elektron314/DMX8x8A-v1/Project Outputs for DMX8x8A-v1/Fabrication/Report Board Stack.xls

Board Stack Report
Stack Up |  | Layer Stack
Layer | Board Layer Stack | Name | Material | Thickness | Constant
1 |  | Top Paste
2 |  | Top Overlay
3 |  | Top Solder | SM-001 | 0.025mm | 4
4 |  | Top Layer | Copper | 0.035mm
5 |  | Dielectric 1 | Core-043 | 1.499mm | 4.3
6 |  | Bottom Layer | Copper | 0.035mm
7 |  | Bottom Solder | SM-001 | 0.025mm | 4
8 |  | Bottom Overlay
9 |  | Bottom Paste
 | Height : 1.619mm
