elektron314/DMX8x8A-v1/Project Outputs for DMX8x8A-v1/Assembly/DMX512 Decoder.xlsx

Designator | qnt | Value | Comment | Description | Footprint
C1, C2 | 2 | 470u 35V | 35ZL470MEFC10X20 | Radial Lead Aluminum Electrolytic Capacitors | CAPPRD500W60D1025H1750
C3, C5, C18:IO1, C18:IO2, C18:IO3, C18:IO4, C19:IO1, C19:IO2, C19:IO3, C19:IO4 | 10 | 1 | 1 50V 5% | Ceramic Chip Capacitor | Chip C 0402 - 1206
C4 | 1 | 1500p | 1500p 25V 20% | Ceramic Chip Capacitor | Chip C 0402 - 1206
C15, C16, C17 | 3 | 10 | 10 50V 5% | Ceramic Chip Capacitor | Chip C 0402 - 1206
C8, C9, C10, C11, C12 | 5 | 0.1 | 0.1 25V 20% | Ceramic Chip Capacitor | Chip C 0402 - 1206
C13, C14 | 2 | 12p or 15p | 12p 25V 20% (15pf) | Ceramic Chip Capacitor | Chip C 0402 - 1206
D2, D9 | 2 |  | SS14 | Surface Mount Schottky Barrier Rectifier 1A | DO-214AC (SMA)
D5 | 1 |  | 1N4749A / BZV85C24 | Zener DO-41 | DO-204AL (DO-41)
D7, D13, D14, D17:IO1, D17:IO2, D17:IO3, D17:IO4, D19:IO1, D19:IO2, D19:IO3, D19:IO4 | 11 |  | P6KE24CA | TVS Axial 600W Unipolar 24V | DIOAD1910W90L670D310 (DO-15)
D20:IO1, D20:IO2, D20:IO3, D20:IO4, D21:IO1, D21:IO2, D21:IO3, D21:IO4 | 8 |  | PDS1040 | 10A SCHOTTKY BARRIER RECTIFIER | PDS1040
F2:IO1, F2:IO2, F2:IO3, F2:IO4, F5:IO1, F5:IO2, F5:IO3, F5:IO4 | 8 |  | 0ZCF0500FF2A | Surface Mount PTC 5/10A | 0ZCF0500FF2A
HL4 | 1 |  | 0603 G 100 | LED 0805 (green) | LED SMD 0805
HL14:IO1, HL14:IO2, HL14:IO3, HL14:IO4 | 4 |  | 3528 B 100 | LED 0805 | LED SMD 0805
J1, J2, J3, J4, J5, J6 | 6 |  | 691135000000 | WR-TBL Serie 1347 Horizontal Cable Entry, Pressure Clamp, pitch 5mm, 3p | 691135000000
L1 | 1 | 100uH | CDRH6D38NP-101NC | SMD Power Inductor 100uH 0.65A 265mOhms | INDPM6767X400N
Q1 | 1 | 8 / 16 Mhz | Crystal HC/49US SMD 16MHZ | HC/49US (AT49) LOW PROFILE SURFACE MOUNT MICROPROCESSOR CRYSTAL | HC49SMD
Q2:IO1, Q2:IO2, Q2:IO3, Q2:IO4 | 4 |  | AON7804 | 30V Dual N-Channel MOSFET | AON7804
R1 | 1 | 3k | 3k 5% | Chip Resistor | Chip R 0402 - 1206
R4, R14, R15, R16, R17, R20, R25, R21, R30, R38:IO1, R38:IO2, R38:IO3, R38:IO4, R39:IO1, R39:IO2, R39:IO3, R39:IO4, R59:IO1, R59:IO2, R59:IO3, R59:IO4, R60:IO1, R60:IO2, R60:IO3, R60:IO4 | 25 | 1k | 1k 5% | Chip Resistor | Chip R 0402 - 1206
R6, R11, R44, R45, R46, R47, R48, R49, R50, R51, R52, R53, R54, R55 | 14 | 10k | 10k 5% | Chip Resistor | Chip R 0402 - 1206
R13, R18 | 2 | 0R | 0R | Chip Resistor | Chip R 0402 - 1206
R36:IO1, R36:IO2, R36:IO3, R36:IO4, R37:IO1, R37:IO2, R37:IO3, R37:IO4 | 8 | 0R1 | KNP700JB-91-0R1 | Resistor 7W Axial | RES7W
S4, S5, S6 | 3 |  | SD-2031 | ROTARY CODED SWITCHES | SD-2031
U1 | 1 |  | LM2594DADJ | 0.5 A, Step-Down Switching Regulator | SOIC-8
U2 | 1 |  | AP2120N-3.3TRG1 | High Speed, Extremely Low Noise LDO Regulator | SOT-23-3 (3)
U3 | 1 |  | STM32F103R8T | Medium-density performance line ARM®-based 32-bit MCU with 64 or 128 KB Flash, USB, CAN, 7 timers, 2 ADCs, 9 com. interfaces | LQFP64 (QFP50P1200X1200X160-64N)
U4 | 1 |  | MAX3283E | 15kV ESD-Protected 52Mbps, 3V to 5.5V, SOT23 RS-485/RS-422 True Fail-Safe Receiver | SOT23-6 (SOT95P280X145-6N)
U5 | 1 |  | FOD617BSD | 4-Pin High Operating Temperature Phototransistor Optocouplers | FOD617BSD
U6 | 1 |  | AM1SS-0505SJZ | Isolated DC-DC Converter 1 Watt | AM1S
