elektron314/DMX8x8A-v1/Project Outputs for DMX8x8A-v1/Etc/DMX8x8A-v1 Schematic Prints.PDF

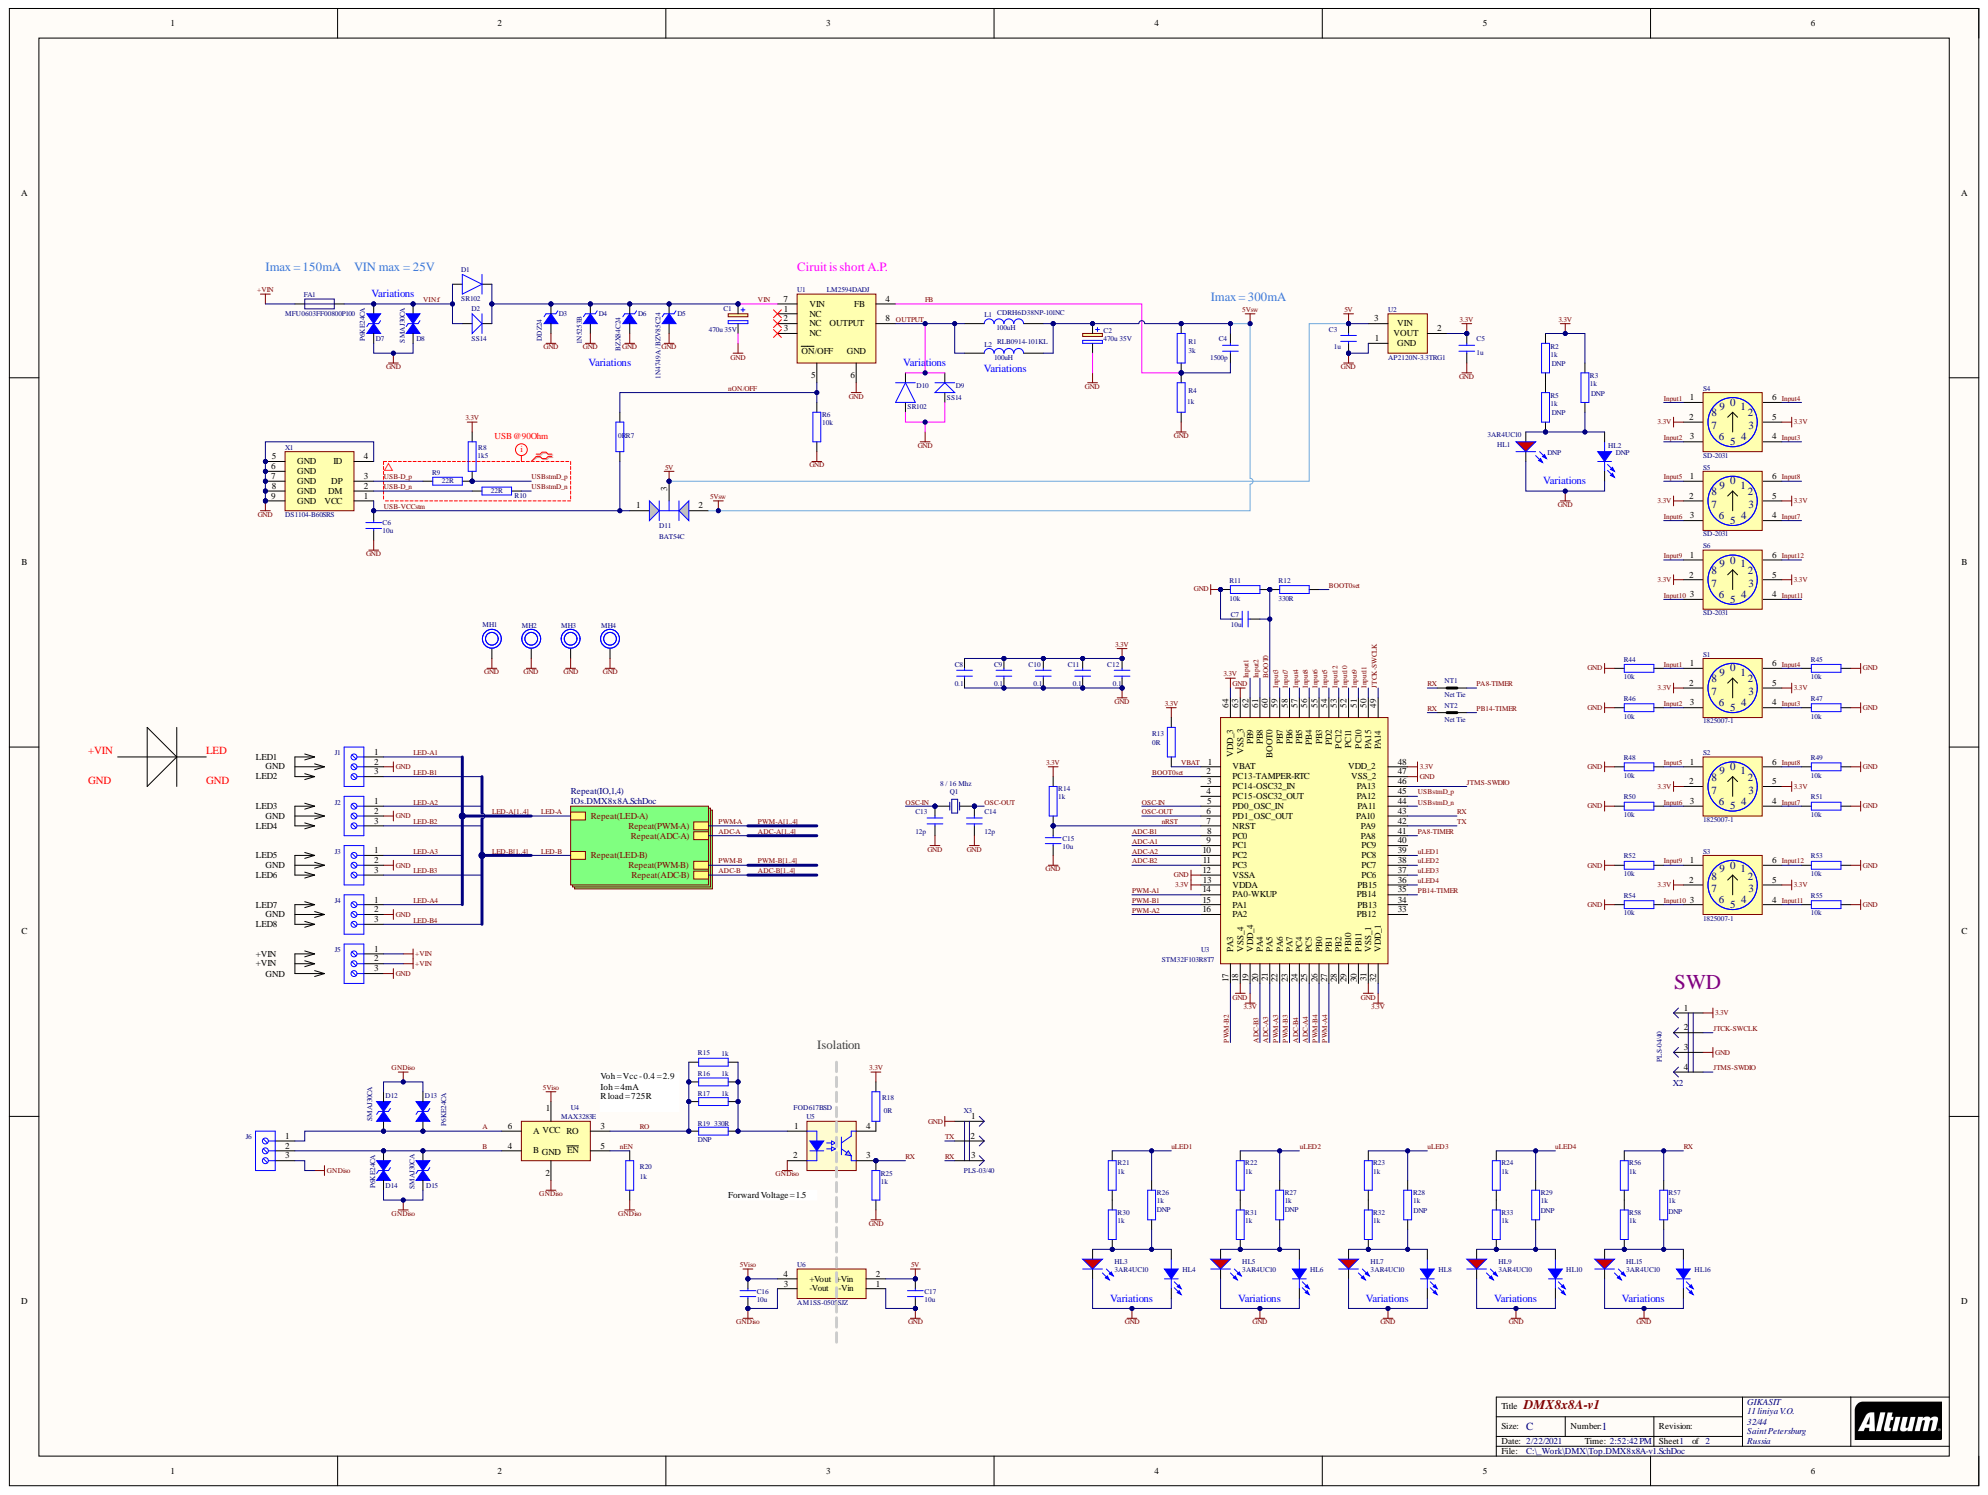
[picture p1: page 1]

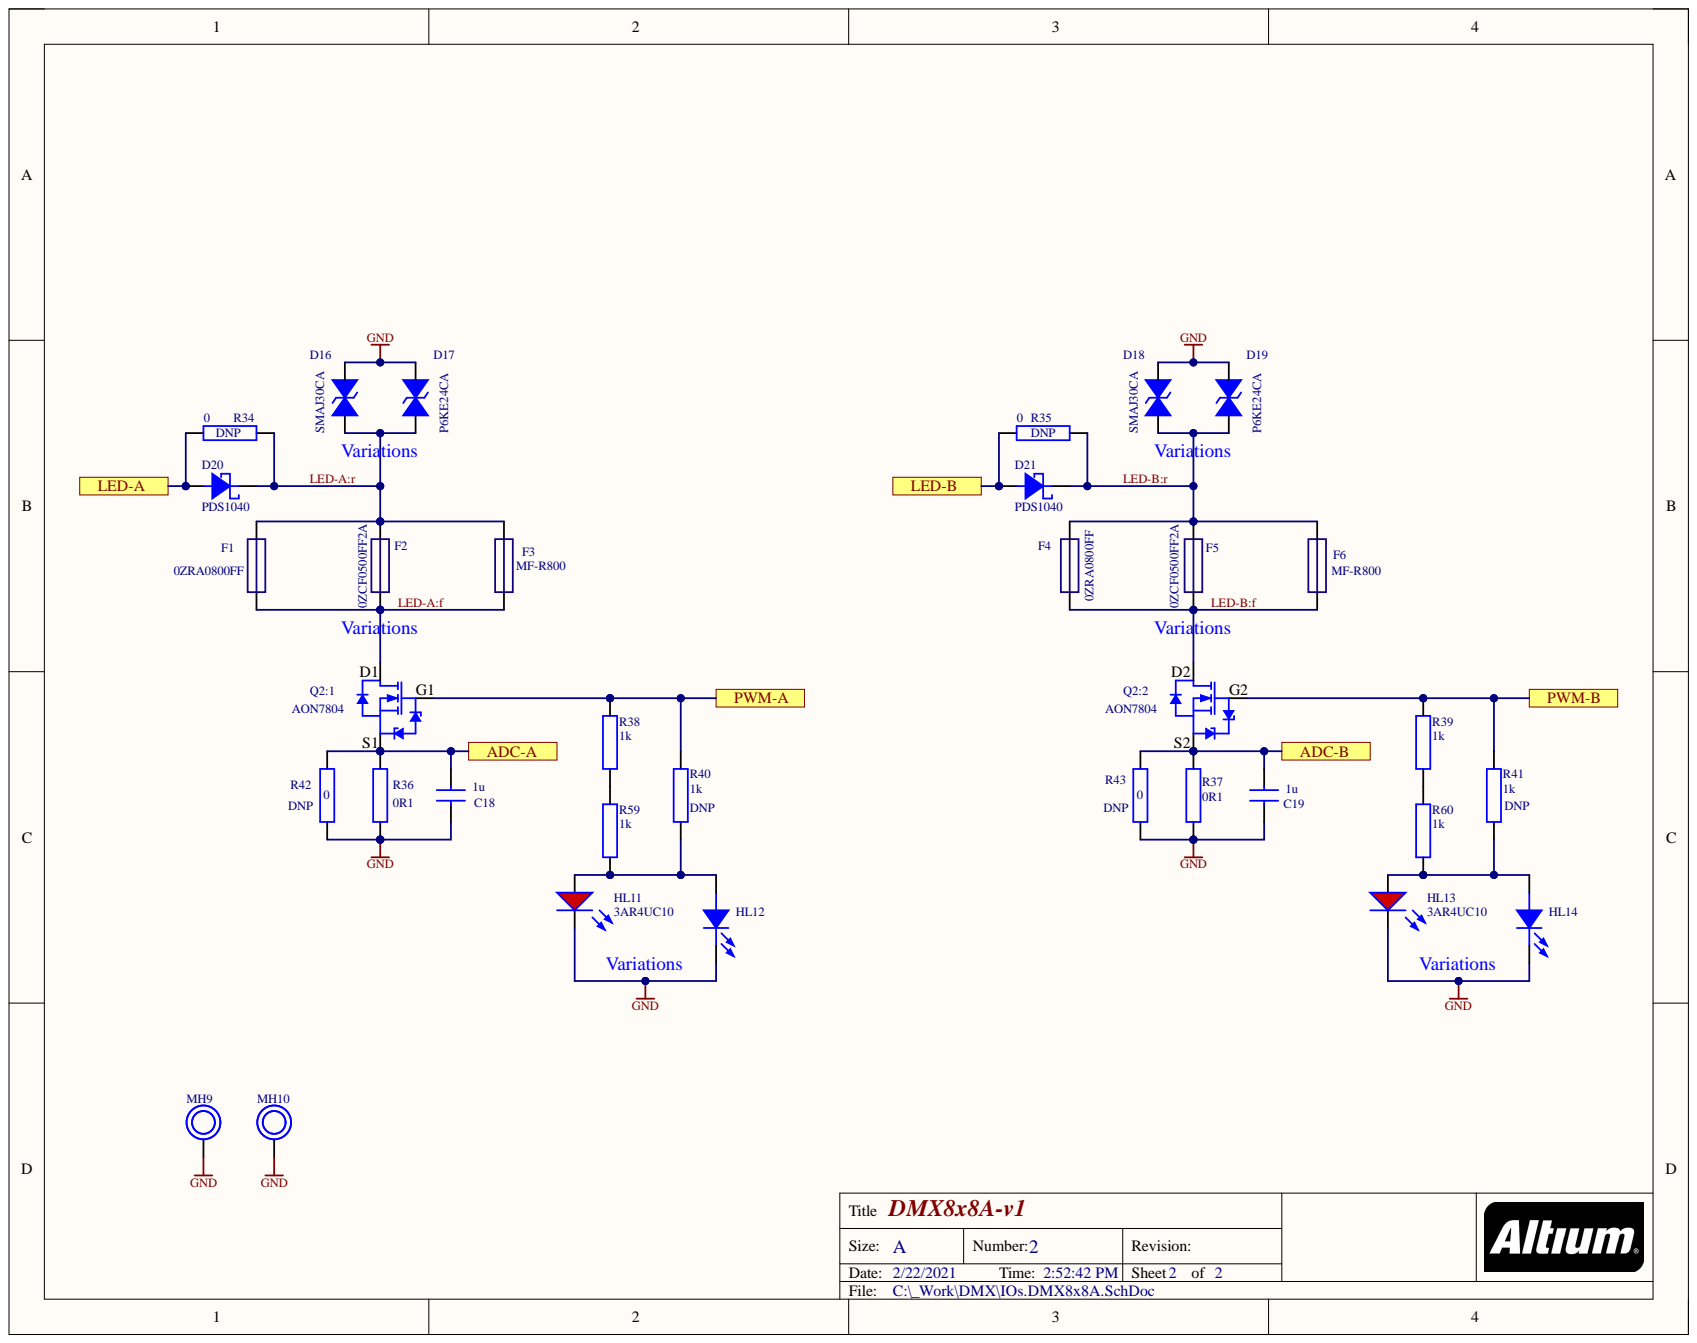
[picture p2: page 2]
