elektron314/DMX8x8A-v1/Project Outputs for DMX8x8A-v1/Assembly/Assembly Drawings.PDF

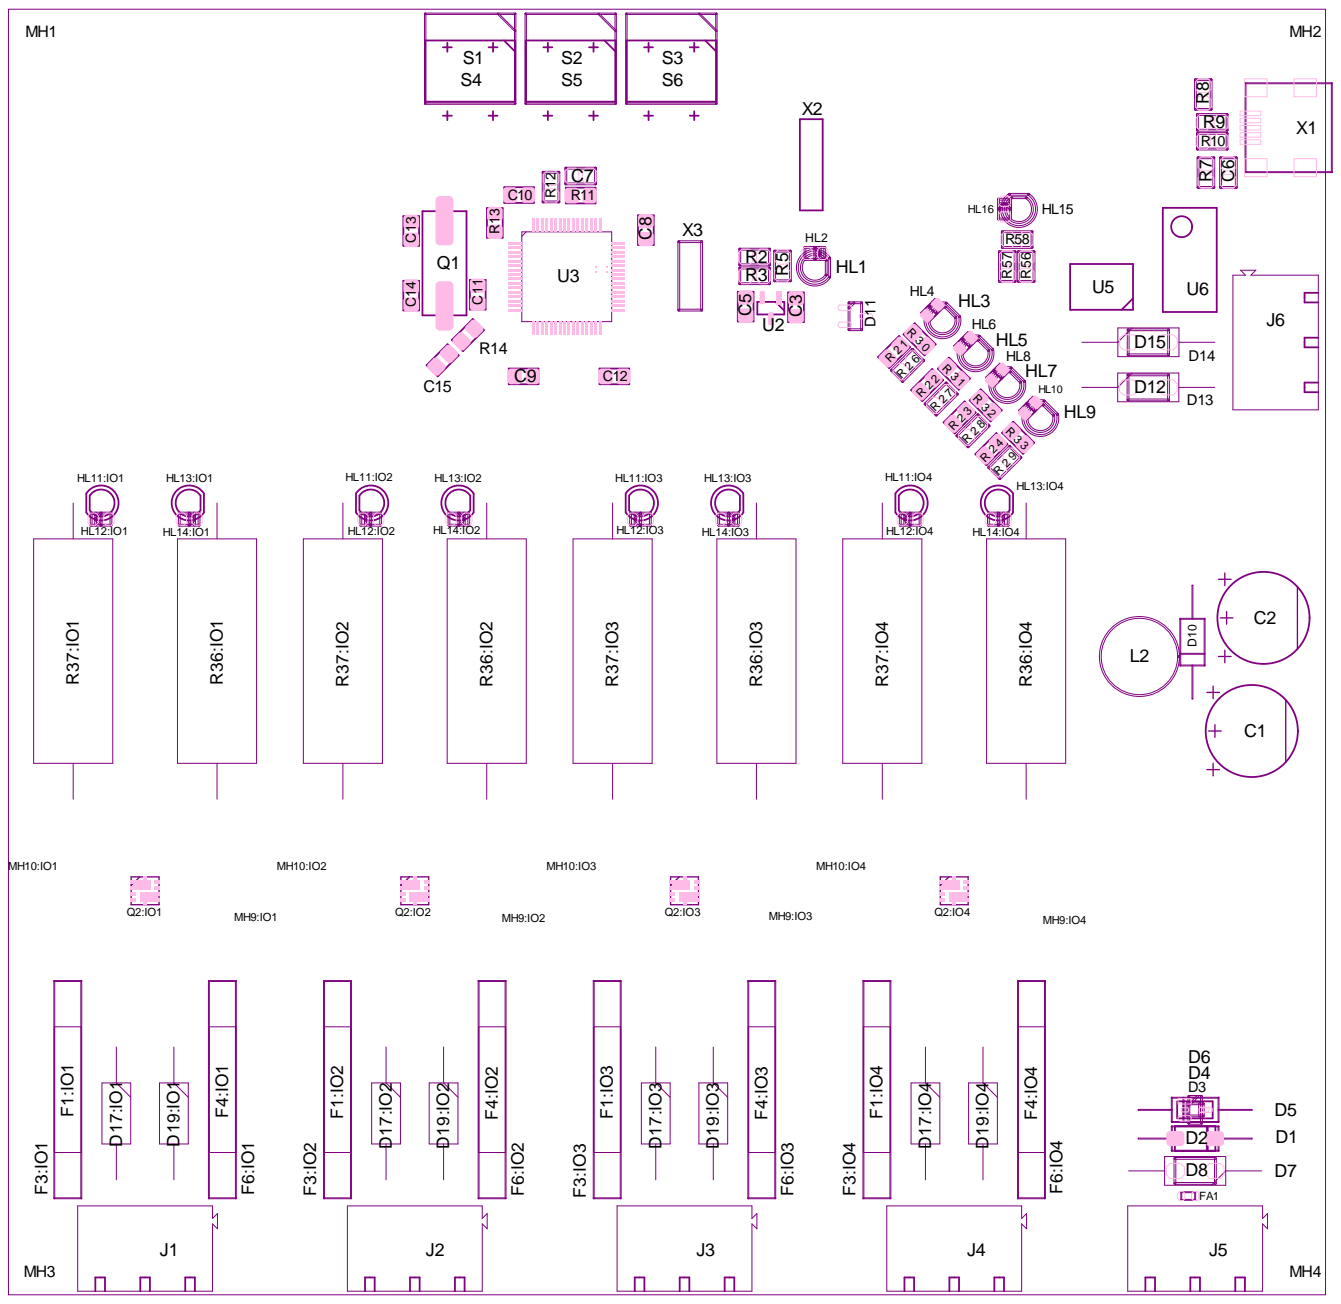
[picture p3: page 1]

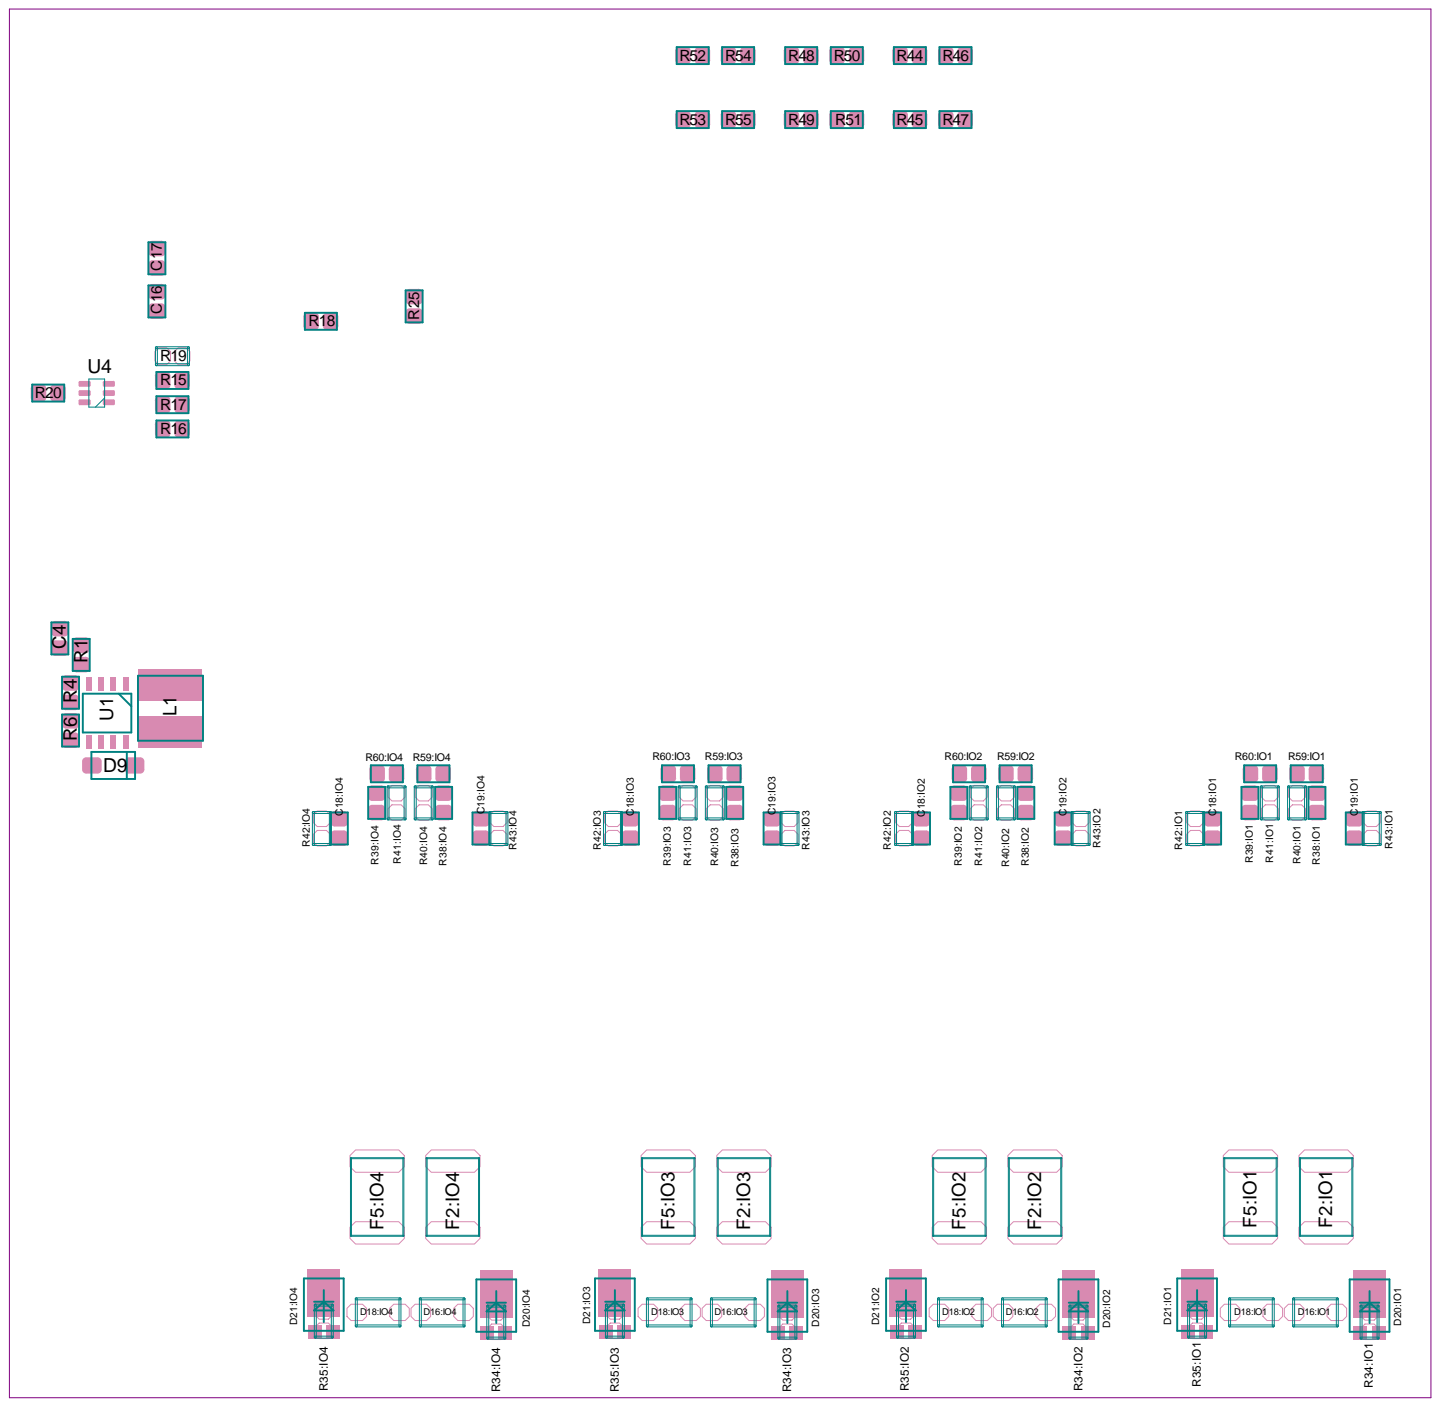
[picture p4: page 2]
