elektron314/DMX8x8A-v1/Project Outputs for DMX8x8A-v1/Etc/PCB 3D Print.PDF

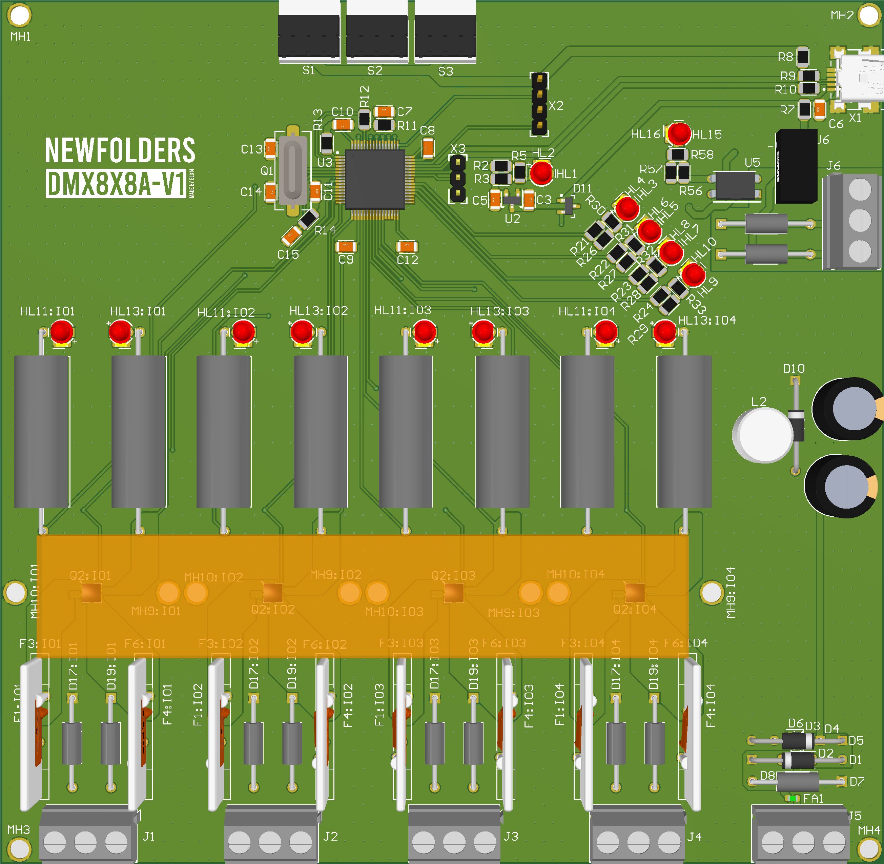
[picture p5: page 1]
