elektron314/DMX8x8A-v1/(list of files, drawings)

Other design files:
DMX8x8A-v1.PcbDoc
DMX8x8A-v1.PrjPcb
DMX512.PcbLib
DMX512.SchLib
IOs.DMX8x8A.SchDoc
Top.DMX8x8A-v1.SchDoc
