elektron314/DMX8x8A-v1/(commit log)

2020-06-03 Justa tupoy amerikanets
    [DMX512.PcbLib, DMX512.SchLib, DMX8x8A-v1.PrjPcb, IOs.DMX8x8A.SchDoc, Top.DMX8x8A-v1.SchDoc]
2020-06-04 Revert "new feature" delete old sch This reverts commit c408ade23bbfd5fcc20b484aa502ee9ebe65ab61.
    [DMX8x8A-v1.SchDoc]
2020-06-05 double IO channel is being routed
    [DMX512.PcbLib, DMX512.SchLib, IOs.DMX8x8A.SchDoc]
2020-06-08 IO channels are almost done
    [IOs.DMX8x8A.SchDoc]
2020-06-10 pcb design in progress
    [DMX512.PcbLib, DMX8x8A-v1.PrjPcb, IOs.DMX8x8A.SchDoc, Top.DMX8x8A-v1.SchDoc]
2020-06-15 some polygons are added
    [Top.DMX8x8A-v1.SchDoc]
2020-06-17 routed: uC, High Current in CH
    [DMX8x8A-v1.PrjPcb]
2020-06-22 some signals are swapped, routing in progress
    [Top.DMX8x8A-v1.SchDoc]
2020-06-23 all channels has been routed
    [DMX512.PcbLib, Top.DMX8x8A-v1.SchDoc]
2020-06-25 RS485 + USB has been routed
    [Top.DMX8x8A-v1.SchDoc]
2020-06-27 almost done, Steve should check it
    [DMX8x8A-v1.PrjPcb, Top.DMX8x8A-v1.SchDoc]
2020-07-20 some connectors were moved to the side ot pcb
    [DMX8x8A-v1.PrjPcb]
2020-07-29 Design is almost ready. Pending on Stevie's dimmensions of heat shrink
    [DMX8x8A-v1.PrjPcb, Top.DMX8x8A-v1.SchDoc]
2020-07-30 Routing has been finished
    [DMX512.PcbLib, IOs.DMX8x8A.SchDoc, Top.DMX8x8A-v1.SchDoc]
2020-08-11 Everything is ready to production
    [DMX8x8A-v1.GBL, DMX8x8A-v1.GBO, DMX8x8A-v1.GBP, DMX8x8A-v1.GBS, DMX8x8A-v1.GM1, DMX8x8A-v1.GTL, DMX8x8A-v1.GTO, DMX8x8A-v1.GTP]
2020-08-12 html rule check file deleted. Mech17 sign changed to more suitable
    [DMX8x8A-v1.PrjPcb]
2020-08-25 BOM: not necessary positions were checked, variants were grouped.
    [DMX8x8A-v1.PrjPcb, IOs.DMX8x8A.SchDoc, Ordering BOM-DMX8x8A-v1.csv, Top.DMX8x8A-v1.SchDoc]
2020-09-09 Filtering caps in measuring net to ADC changed footprint to universal. After that all fab files were regenerated with new file structure.
    [DMX8x8A-v1.PrjPcb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]
2020-09-09 old gerber files deleted
    [DMX8x8A-v1.GBL, DMX8x8A-v1.GBO, DMX8x8A-v1.GBP, DMX8x8A-v1.GBS, DMX8x8A-v1.GM1, DMX8x8A-v1.GTL, DMX8x8A-v1.GTO, DMX8x8A-v1.GTP]
2020-09-09 pdf about device split into 2 different pdfs and moved to Etc folder
2021-01-28 D11: Not necessary -> Necessary with USB
    R40: Not necessary deleted
    Fixed Assembly.OutJob: Changed Assembly BOM: Show Not fitted added, SMD/TH deleted
    Assembly Drawings.PDF: Redundant components deleted
    [DMX512 Decoder.xlsx, DMX8x8A-v1.PrjPcb, DMX8x8A-v1.xlsx, IOs.DMX8x8A.SchDoc, Ordering BOM.csv, Ordering BOM.xlsx, Top.DMX8x8A-v1.SchDoc]
2021-01-28 fixed commit
    [DMX8x8A-v1.PrjPcb]
2021-01-28 nadeus teper vse ok
    [DMX512 Decoder.xlsx, DMX8x8A-v1.PrjPcb, DMX8x8A-v1.xlsx, IOs.DMX8x8A.SchDoc, Ordering BOM.xlsx, Top.DMX8x8A-v1.SchDoc]
2021-02-22 fix schematics text
    [IOs.DMX8x8A.SchDoc, Top.DMX8x8A-v1.SchDoc]
